catox0/Fast-Laser-Shutter/20190722_171411_HDR.jpg

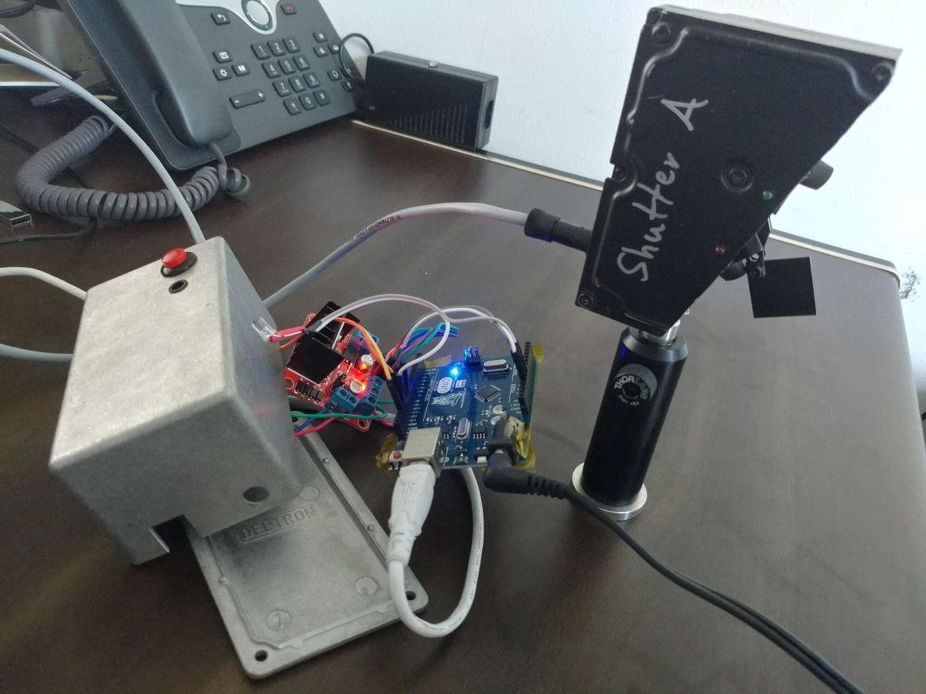
20190722_171411_HDR.jpg
